terrillmoore/fatif-adapter/(commit log)

2026-02-08 Three-piece laminated Fatif DS adapter lensboard
    CadQuery script generates laser-cut parts for SendCutSend:
    front sheet (2.0mm), middle light-seal sheet (0.5mm), rear sheet (3.0mm),
    plus Cambo-style retention clips. Includes earlier design files
    (OpenSCAD, FreeCAD, HTML drawing) for reference.
    [fatif_adapter_lensboard.scad]
2026-02-08 Remove obsolete single-piece CNC design files
    Superseded by the three-piece laminated design in
    fatif_adapter_cadquery.py. Old files remain in git history.
    [fatif_adapter_lensboard.scad]
2026-02-08 Update dimensions from caliper measurements of Fatif original
    Replace estimated dimensions with caliper-verified measurements:
    - Board: 171.5mm sq (was 170), R50.75 (was R50), step 5.75mm (was 7.5)
    - Front: .063 6061 powder coated (1.78mm, was 2.0)
    - Middle: .025 2024-T3 bare (0.64mm, was 0.5)
    - Rear: .100 6061 black anodized (2.56mm, was 3.0)
    - Lip: 2.42mm (within 2.50mm clip limit)
    - Total: 4.98mm (was 5.5)
2026-02-09 Redesign clips: dog-bone top clip with 45-deg cam slots, flat bottom clip
    Top clip (Crown Graphic style):
    - Dog-bone profile: straight outer edge, profiled inner edge
    - Wide ends (14mm) grip the board, narrow middle (8mm) for nameplate
    - 135-deg cam slots for cam action (push -X to open, gravity closes)
    - Bent tabs at both ends for finger grip
    - 9mm slot length, 5.6mm travel, 4.0mm Y retraction
    Bottom clip:
    - Simple 90mm x 10mm rectangular bar, fixed with 2 screws
    - No bent tabs (fixed clip, nothing to grip)
    Other changes:
    - Color-coded assembly STEP via cq.Assembly
    - Separate screw Y offsets for top/bottom clips
    - Countersinks only on assembly screws (clip screws use pan heads)
    - Clip DXF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
2026-02-09 Set clip material to .060 inch 304 stainless steel (1.52mm)
2026-02-09 Add nameplate mockup: full-clip paint fill with Futura text
    Two-panel visualization of the painted top clip nameplate design
    (Crown Graphic style). Black paint covers the full clip face with
    1mm inset margin, cam slots showing bare stainless through. "fatif"
    in Futura Medium with 1-en letter spacing, pixel-perfect vertical
    centering via Pillow ink-bound measurement.
2026-02-09 Add rounded corners and slot clearance zones to paint design
    Match Crown Graphic aesthetic: paint outline now has 2mm radius
    fillets at all corners (taper transitions, end caps). Bare-metal
    slot clearance zones (stadiums) around cam slots prevent screw-head
    paint scratching. Cam slot holes rendered as dark through-cuts.
2026-02-09 Fix slot clearance to match Crown Graphic: simple racetrack per slot
    Replace oversized stadium clearance zones with a single 1mm-margin
    racetrack around each slot hole, matching the paint edge inset.
    Screw head sits on top of paint (aesthetic, not functional clearance).
2026-02-09 Fix stadium geometry and racetrack rendering
    The stadium_points() function was generating a self-intersecting bowtie
    shape instead of a proper discorectangle. Rewrote to correctly trace two
    semicircular end caps connected by parallel straight sides. Increased
    slot clearance margin to 2.5mm for a visible racetrack, removed edge
    lines from clearance fills so they blend into unpainted clip edges.
2026-02-09 Reduce clip overlap to 2mm and fix mockup clip positions
    Changed CLIP_OVERLAP from 3.5mm to 2.0mm to allow angling the Gowland
    board in during insertion. Fixed mockup bottom clip coordinates which
    were completely wrong (inner edge outside the cutout, zero board overlap).
    Both clips now correctly straddle the Gowland cutout with 2mm overlap.
2026-02-09 Narrow slot racetrack to 1mm margin; stop tracking generated PNG
    Reduced SLOT_CLEAR_MARGIN from 2.5mm to 1.0mm to match the paint edge
    inset. Added fatif_nameplate_mockup.png to .gitignore and removed from
    tracking since it is a generated file. Added make mockup target and
    included the PNG in make clean.
2026-02-09 Redesign top clip tab: single 45° rectangular tab (Crown Graphic style)
    Replace dual straight tabs with single rectangular tab at upper-left corner.
    The 45° bend line runs from A(-33, 81.5) to B(-45, 69.5), and the tab
    extends perpendicular to it by TAB_HEIGHT (8mm). Body has chamfered corner
    at the bend line; DXF flat pattern includes full tab material. Bottom clip
    and body corners get R2 radii. Save reference sketch for tab geometry.
2026-02-09 Add corner radii, closed-position display, and screw centering
    - R2 corner radii on DXF flat pattern (5 corners: 3 body + 2 tab outer)
    - Top clip shown in closed (gravity) position in mockup
    - Screw X offset centers clip in closed position (~1.98mm)
    - TAB_BEND_RUN reduced 12→10mm for consistent corner radius
    - Paint left edge follows offset bend line (fix constant -114.5→-116.5)
    - Paint margin from bend line reduced to match other edges (1mm)
    - Per-vertex radii in mockup (R2 body, 0 at bend endpoints A/B)
2026-02-09 Fix paint outline, add corner radii to 3D model and taper transitions
    Mockup fixes:
    - Fix vertex ordering in paint outline (was creating spike at -X,-Y corner)
    - Fix taper X sign error (left taper was 5mm outside clip boundary)
    - Move clamping vertices to end of list for correct polygon winding
    CadQuery fixes:
    - Add R2 fillets to 3D top clip body (7 corners: 3 body + 4 taper)
    - Assembly STEP now shows rounded corners (was sharp)
    - Add 4 taper transition fillets to DXF flat pattern (9 total now)
2026-02-09 Add R2 fillets to tab outer corners (A', B') in 3D STEP files
    NearestToPointSelector targets the thickness-direction edges at
    the top of the tab after body+tab fusion. Both individual clip
    STEP and assembly STEP now show rounded tab corners matching the
    DXF flat pattern.
2026-02-09 Center each top clip screw in its wide end when fully closed
    Each screw is now positioned so it sits at the center of its
    respective wide end (X=[-45,-20] or [+20,+45]) when the clip
    is in the closed/gravity position. Top clip X spacing changed
    from 50mm (symmetric) to 65mm (each screw at wide end center
    + closed-position offset). Bottom clip screws unchanged at 50mm.
2026-02-09 Move adapter screw holes to wide end centers so clip is centered when closed
    Separate adapter screw positions (-32.5, +32.5) from clip slot positions
    (-30.52, +34.48). Adapter holes at wide end centers ensure the clip body
    is centered on the adapter in the gravity/closed position. Clip slots are
    offset by _closed_dx so screws sit at the +135° end of slots when closed.
2026-02-09 Add GOWLAND nameplate to bottom clip in Futura Light
    Paint area covers bottom clip with 1mm inset, no screw clearance
    (black pan-head screws). Three-panel mockup: full view, top clip
    detail (fatif), bottom clip detail (GOWLAND). Text height matches
    fatif; draw_spaced_text now accepts font_prop parameter.
2026-02-09 Add paint artwork SVG generation, hardware BOM, and README updates
    New script generate_paint_artwork.py generates vector SVGs for clip
    paint masks with text-as-outlines (even-odd fill for letter cutouts).
    Uses matplotlib TextPath for Futura glyph extraction.
    README: fix stale clip overlap (3.5→2.0mm), tab description (single
    45° tab), add nameplate paint section, hardware BOM table, mention
    make mockup/artwork targets, update generated files table.
2026-02-09 Remove screw hole circles from bottom clip paint SVG
    Black screws blend with paint; no reference marks needed.
2026-02-09 Remove slot outline reference marks from top clip paint SVG
    Slot clearances are already no-paint cutouts in the mask; redundant
    gray outlines just add clutter.
2026-02-11 Add fabrication checklist
    Step-by-step ordering and assembly guide covering SendCutSend
    (aluminum sheets), Ponoko (SS clips with silkscreen), hardware
    sourcing, and final assembly/testing.
2026-02-11 Move output to output/ directory, switch to pan head assembly screws
    - All generated artifacts (STEP, DXF, PNG, SVG) now go to output/
    directory, configurable via OUTPUT_DIR make variable
    - All scripts accept --output-dir argument
    - Replace M3 flat head assembly screws with M3 pan head black oxide
    (countersinking unavailable on .063 inch sheet at SendCutSend)
    - Remove countersink modeling from CadQuery script
    - Simplify .gitignore to just ignore output/
2026-02-11 Add bend line to top clip DXF, note middle sheet deburring
    - Top clip DXF now includes bend line on Bend layer (green, color 3)
    so Ponoko can distinguish bend from cut operations
    - FABRICATION.md: note deburring unavailable for .025 inch middle sheet
2026-03-20 Add CNC single-piece body variant -- 0.250 inch 6061-T6 billet
    Alternative to three-piece laminate: single CNC-milled body with
    rear perimeter step for 2.42mm lip, front board pocket 139mm sq
    1.78mm deep, 110mm through-bore, and 4x M3 roll-tap holes for
    clip screws. Eliminates middle sheet and 2 assembly screws.
    Generates fatif_cnc_body.step and fatif_cnc_assembly.step
    alongside existing laminate outputs.
2026-03-20 Update docs for CNC single-piece variant, add CLAUDE.md
    - README.md: add CNC design section, hardware BOM, fabrication notes,
    generated files, surface finish notes
    - FABRICATION.md: add CNC ordering option, variant-specific assembly steps
    - CLAUDE.md: add to repo with CNC parameters, vendor notes, hardware
    - .gitignore: add scratch/
2026-07-19 Add corner-radius test comb for casting fit verification
    First-fab corners came out too tight (flats seat, corners too pointy).
    Computed new targets: front+middle R50.75->~53.36, rear R45->~47.4
    with -0.5mm X-Y (160->159.5). The 45-deg setback s=R*(sqrt2-1) gives
    dR=2.414*dd, so a small diagonal interference is a large radius change
    -- bracket rather than trust one blank.
    generate_corner_comb.py emits a single DXF of labeled convex corner
    gauges (outer R52.0-54.0, rear R46.5-48.0, 0.5mm steps) with 30mm
    registration flats. Cut cheap/unfinished, drop into each casting corner,
    pick the flush one. Wired up as 'make blanks'.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
2026-07-21 Add uv project config (pyproject.toml + uv.lock)
    Dependency scaffolding for the uv migration (issue #1). Declares
    cadquery 2.6.1, ezdxf, matplotlib, numpy, pillow; pins nlopt==2.9.1
    (the newest release still shipping macOS x86_64 wheels alongside
    arm64/win/linux, so the lock resolves on Intel-Rosetta and native
    arm64 uv and Windows). Scripts run today via 'uv run python <script>.py'.
    Makefile recipe conversion and README/CLAUDE.md build-doc updates
    still pending -- issue #1 stays open until then.
    Claude-Session: https://claude.ai/code/session_012VRNGHXeEdhSECRjSM73EW
2026-07-21 Open Gowland board cutout for powder-coat clearance
    The 6x6 board rubbed on the sides after coating. Cutout was 139.0/R3.4
    against a 138.5mm nominal board -- only 0.50mm bare diametral clearance,
    and both the board and the front sheet are powder coated (~0.163mm/
    surface), which consumes 4*0.163 = 0.652mm, netting slight interference.
    Board dims measured from the vector art in ../lensboards/138mm:
    outer 392.599pt = 138.5mm, corner tangent at 9.814pt = R3.462 (the old
    3.4 was under the true board corner, so cutout corners bound too).
    GOWLAND_SIZE 139.0 -> 139.75 (138.5 + 4*coat + 2*0.30 clearance)
    GOWLAND_CORNER_R 3.4 -> 4.09 (board R3.462 + 0.626, uniform gap)
    Targets ~0.3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
2026-07-21 Convert build from venv to uv; update docs (closes #1)
    Rewrite the Makefile to run every script via 'uv run' and replace
    'make init' (python3 -m venv + pip) with 'uv sync'. Drops the hardcoded
    $(VENV)/bin path layout that broke on Windows (bin vs Scripts) and the
    python3-vs-python problem -- uv resolves the interpreter and deps itself,
    identically on macOS/Linux/Windows.
    Docs: README Quick Start + Prerequisites now describe the uv workflow,
    the direct 'uv run python <script>' path, and the Windows route (Git Bash
    + 'scoop install make'). CLAUDE.md Build section and conventions updated
    to match; note the nlopt==2.9.1 cross-platform pin.
    Verified native arm64: make init/all/blanks all green,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
2026-07-21 Give CNC pocket its own dimensions (anodize, not powder coat)
    The CNC pocket reused the laminate cutout constants (GOWLAND_SIZE 139.75
    / R4.09), but those assume a powder-coated wall (0.163mm/surface). The CNC
    body is anodized (~0.02mm/surface), so the pocket wall removes far less
    material and the board sat ~0.14mm/side looser than the 0.30mm target.
    Add CNC_POCKET_SIZE=139.47 / CNC_POCKET_R=3.95, derived for the same
    ~0.30mm/side finished fit with the board's powder coat but an anodized
    pocket wall: 138.5 + 2*(0.163 + 0.02 + 0.30) and 3.462 + 0.483. Laminate
    GOWLAND_SIZE/R untouched.
    Claude-Session: https://claude.ai/code/session_012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
2026-07-21 Rework corner comb for SendCutSend: connected combs, cut-through labels
    Regenerate the comb as two CONNECTED combs (teeth on a spine) instead of
    nine loose gauges -- SCS bills disconnected shapes as separate parts with
    per-part minimums, so a comb is one part each (2 parts pre-nested) and far
    cheaper, plus easier to handle.
    Radius values are now cut clean THROUGH each tooth as 7-segment numerals:
    SCS does no solid/raster engraving (only single-line etch on SCS_SLE, which
    needs a checkout note + eligible material), and 7-seg slots have no font
    islands to drop out. All geometry is closed contours on a single layer '0'.
    Verified: 145 closed LWPOLYLINEs, 2 comb outlines + 143 slots, labels rea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
2026-07-21 Double corner comb tooth gap (16 -> 32mm) for corner access
    More clearance around each tooth's corner to press it into the casting
    corner without the neighbor interfering. Comb now ~522mm wide.
    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
2026-07-22 Trim outer comb to 4 teeth (drop R52.0), match rear bracket width
    Outer had 5 teeth (52.0-54.0) vs rear's 4 (46.5-48.0) for no reason --
    same 0.5mm-step, same one-target problem. Center 4 teeth on the calc
    R53.36: 52.5, 53.0, 53.5, 54.0 (two below, two above). Combs now equal
    width (~416mm), same confidence as the rear.
    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
2026-07-22 Switch corner test from comb to two square frames
    Replace the comb with two square frames -- each corner of a square carries
    a different candidate radius, so you push each corner into the casting
    corner to test it (OUTER square: 52.5/53.0/53.5/54.0; REAR: 46.5/47.0/
    47.5/48.0). Register on one corner + its two flats, rotate for the next.
    Renamed generate_corner_comb.py -> generate_corner_squares.py, output
    fatif_corner_squares.dxf. Each frame is a constant-width band (outer +
    inner closed contour); radius values cut clean through the thick corner
    band as small horizontal 7-seg numerals (rotated digits proved unreadable;
    the 24mm band holds a horizontal label with clearance from both contour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
2026-07-22 Lengthen corner-square registration flats (FLAT_MIN 18 -> 50mm)
    Longer straight edges register far better against the casting flats when
    seating a corner. Gauges grow to 157.5mm (outer) / 145.5mm (rear) square,
    still under the real profiles (171.5 / 160). Corner arcs and labels
    unchanged.
    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
2026-07-22 Stamp corner-squares DXF as millimeters ($INSUNITS=4)
    Ponoko read the unit-flagged file as inches and scaled it 25.4x (157.5mm
    -> 4000mm). ezdxf's default was meters ($INSUNITS=6), which Ponoko ignored.
    Set doc.units = MM and $MEASUREMENT = 1 so any vendor reads true size.
    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
2026-07-22 Split corner squares into two separate DXFs (one part each)
    Ponoko treats each uploaded DXF as a single part, so emit the outer and
    rear gauges as fatif_corner_squares_outer.dxf (157.5mm) and
    fatif_corner_squares_rear.dxf (145.5mm) instead of one nested file. Both
    mm-stamped, closed contours on layer 0. Dropped the unused SQUARE_GAP.
    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
2026-07-22 Corner gauges: solid squares + printed key (cut Ponoko/laser cost)
    Ponoko quoted ~$95 for the two labeled frames -- laser cost tracks pierce
    count, and the per-corner 7-seg numerals were ~65 tiny pierces per part.
    Redesign for cheap throwaway gauges:
    - SOLID squares (no inner hole), no cut-through labels -- DXF is now just
    2 outlines + 2 holes (was ~130 entities).
    - One small orientation hole per square marks the smallest-R (BL) corner,
    biased toward the bottom edge so orientation is flip-proof (the part is
    otherwise mirror-symmetric).
    - New fatif_corner_squares_key.pdf: printed reference mapping each corner
    to its radius. Do not cut it.
    - Both squares nested in one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
2026-07-22 Split corner squares back into two DXFs (SCS prices per part)
    SCS charges per part and its instant-quote UI keys the size (and which
    thickness/finish options it shows) off the whole file's bounding box, so a
    nested file both misreads the part size and hides options. Emit
    fatif_corner_squares_front.dxf (157.5mm) and _rear.dxf (145.5mm) again,
    one solid square + orientation hole each. Key PDF still shows both.
    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
2026-07-30 This is v0.2; fix dependencies after x86>Apple ARM fix
2026-07-31 Apply confirmed casting corner radii + rear size to production sheets
    2nd-round bare-aluminum gauges pinned the casting corners at R54.5 (front/
    outer) and R49.5 (rear). Applying to the laminate (and CNC) design:
    BOARD_CORNER_R 50.75 -> 54.34 (54.5 casting - 0.163 powder coat)
    REAR_CORNER_R 45.0 -> 49.48 (49.5 casting - 0.02 anodize), decoupled
    REAR_SIZE 160.0 -> 159.5 (-0.5mm; first fab fouled the inner rib)
    STEP_WIDTH now derived = (BOARD-REAR)/2 = 6.0mm lip (was 5.75)
    Coat is subtracted because laser kerf CANCELS between the bare gauges and
    the coated production parts (same laser) -- it does not offset coating, so
    the drawn corner must be cut smaller by the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
2026-08-01 Coat-compensate board SIZE too, not just corner radius (preserve arc center)
    Reducing only the corner radius for coating was inconsistent: coating adds
    t normal to every surface, so flats move out t, the convex corner radius
    grows t, and the arc center stays put. Cutting the radius alone (size held
    at finished) leaves the corner center ~0.16mm/axis too far out -> the corner
    pokes out. The size must be shrunk too.
    Rework in a FINISHED (coated) frame; cut = finished - coat (size -2t,
    radius -t), which preserves the center by construction:
    FRONT_COAT 0.163 (powder), REAR_COAT 0.02 (anodize)
    BOARD_FINISH 171.5 / R54.5 -> cut BOARD_SIZE 171.174, R 54.337
    REAR_FINISH 159.5 / R49.5 -> cu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
